shajeebtm/Arduino-audio-spectrum-visualizer-analyzer/images/32x8_LED_matrix.jpg

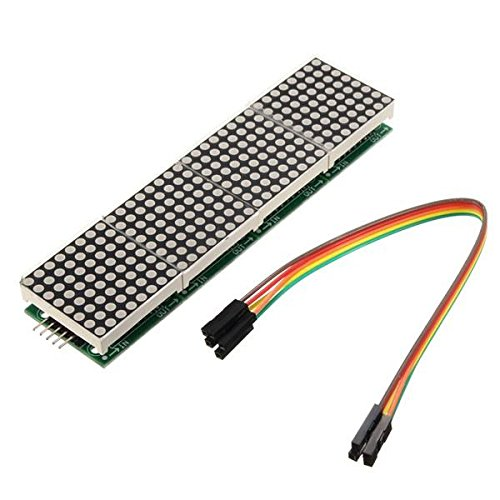
images/32x8_LED_matrix.jpg
