shajeebtm/Arduino-audio-spectrum-visualizer-analyzer/(threads)

Thread 2 (2019-05-31):

Set specific barriers for each column?

enoxitus, 2019-05-31:
I'm new to Arduino programming and barely understand how your program works, but I'm very much trying to replicate a similar project. I need to set barriers like column1 is 50-150hz, column2 is 151-250hz etc. And then set the rows according to the dezibels or amplitude.
For example: I have a 100hz sine wave that's loud as possible, so only column1 should light up.
Could you help me with that? I'd gladly appreciate your help

Thread 4 (2020-04-28):

Missing Audio Jack?

HeathNaylor, 2020-04-28:
Looking at the components required and the schematic diagram, it seems that you are missing an audio jack component [like this one](https://www.sparkfun.com/products/12639).

I assume any component that carries two channels would be fine?

Thread 5 (2021-04-26):

Project

Zabegalova-A, 2021-04-26:
Hey
I really need your help to create this project.
I dont have any mind how many wires i need to connecting all. Im going to recreate your project on my final test and it seems too hard for me to get it.
I need your answer: how many wires are there? Can you picture above view to help me understand how things connects to each other? I have only month for this work and im a little scared about everything that i cant get.
I really-really need your help.
You can connect me on instagram or email.
obyatinskaya1212 - inst
a_zabegalova@inbox.ru - email

Stanislav8889, 2021-04-26:
с чего вы взяли что это мой проект

пн, 26 квіт. 2021 о 16:48 Zabegalova-A ***@***.***> пише:

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

Zabegalova-A, 2021-04-27:
> с чего вы взяли что это мой проект пн, 26 квіт. 2021 о 16:48 Zabegalova-A ***@***.***> пише:
> […](#)
> Эй, мне очень нужна твоя помощь, чтобы создать этот проект. Я не знаю, сколько проводов мне нужно, чтобы соединить все. Я собираюсь воссоздать ваш проект на моем последнем тесте, и мне кажется, что это слишком сложно для меня. Мне нужен ваш ответ: сколько там проводов? Можете ли вы представить вид выше, чтобы помочь мне понять, как вещи соединяются друг с другом? У меня есть только месяц для этой работы, и я немного боюсь всего, что я не могу получить. Мне очень-очень нужна твоя помощь. Вы можете подключить меня на instagram или по электронной почте. обятинская 1212 - инст ***@***.*** - электронная почта — Вы получаете это, потому что подписаны на этот поток. Ответьте на это письмо напрямую, просмотрите его на GitHub#5>, или отписаться ><https://github.com/notifications/unsubscribe-auth/ATJ4NZAGQX2J3PAXHJMYR3LTKVVLBANCNFSM43S5UUHQ> .

радость моя, мне нужно, чтобы этот индус мне ответил, а не ты.
